botanicfields/BF-005/bf-005.jpg

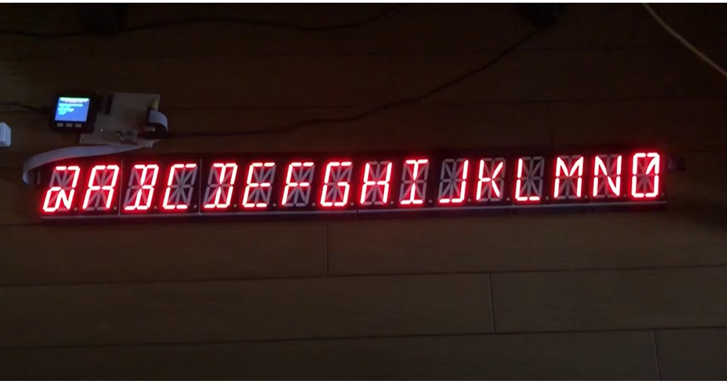
bf-005.jpg
