botanicfields/BF-005/20190802_M5Stack_TLC5940.pdf

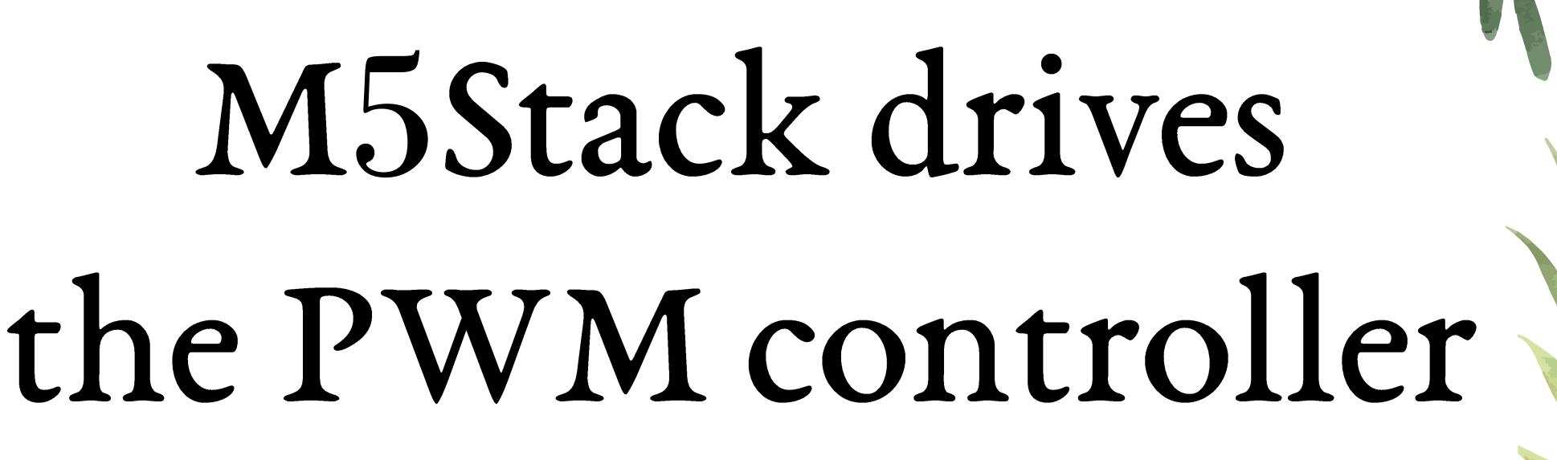
[picture p2: figure]

# TLC5940

16

2019/8/2

2019

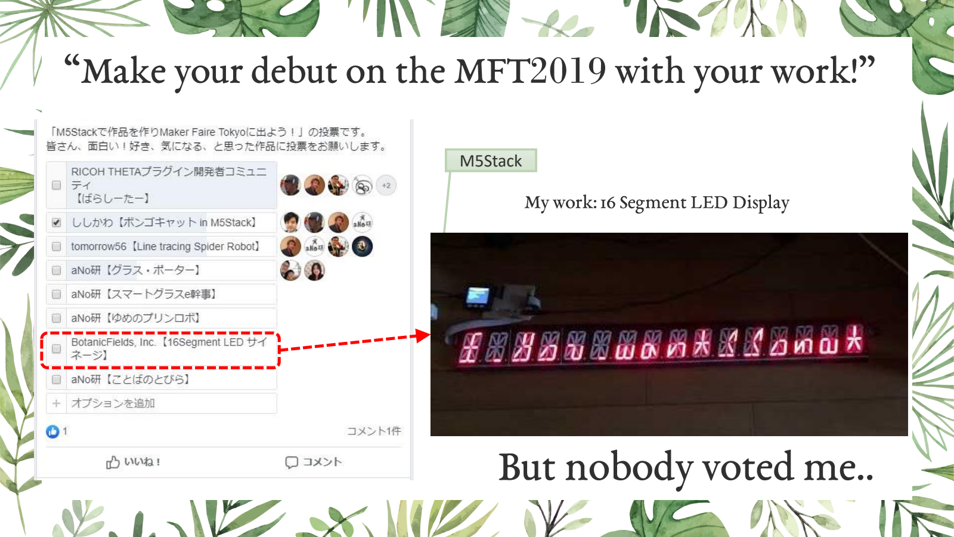
[picture p3: page 2]

M5Stack

# TLC5940

?

# TLC5940

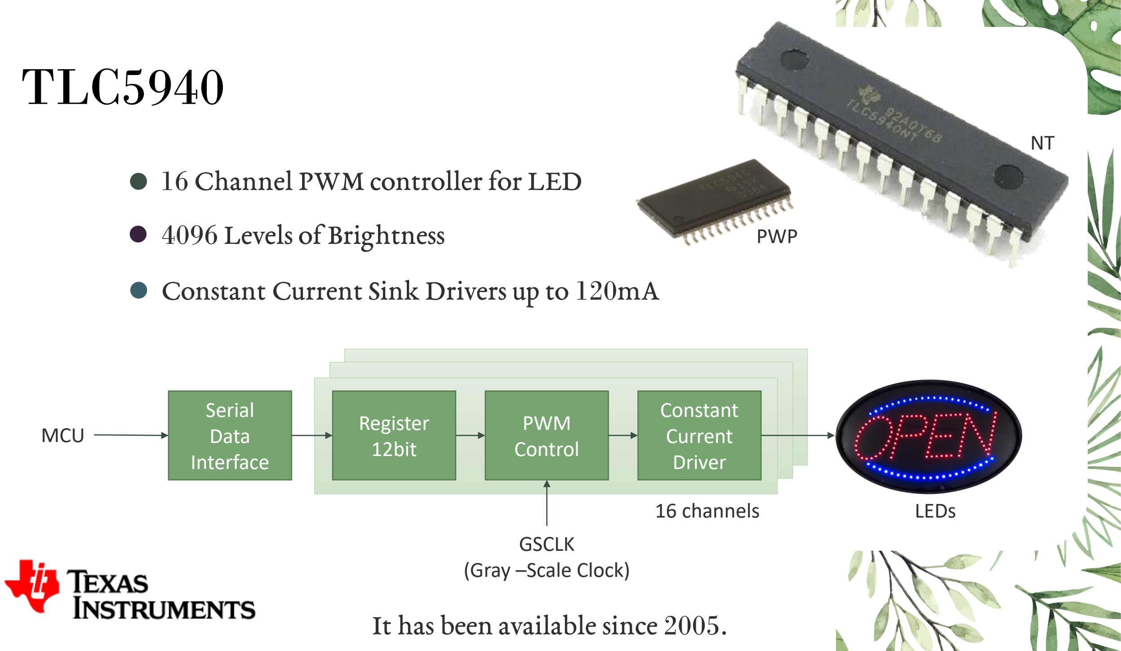
[picture p4: page 4]

120

16

4096

2005.

Constant
Current
Driver

PWM
Control

Register
12bit

Serial
Data
Interface
16 channels | LEDs

MCU

PWP

NT

GSCLK
(Gray –Scale Clock)

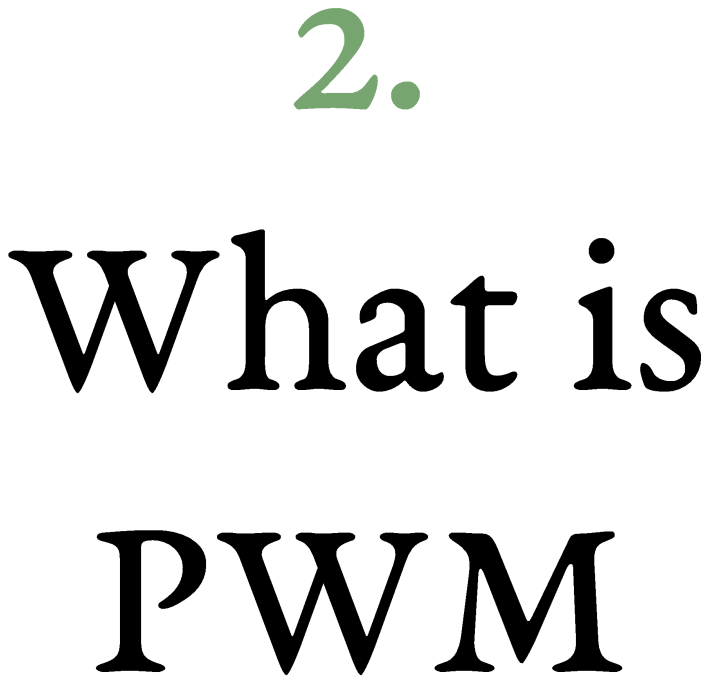
[picture p5: figure]

?

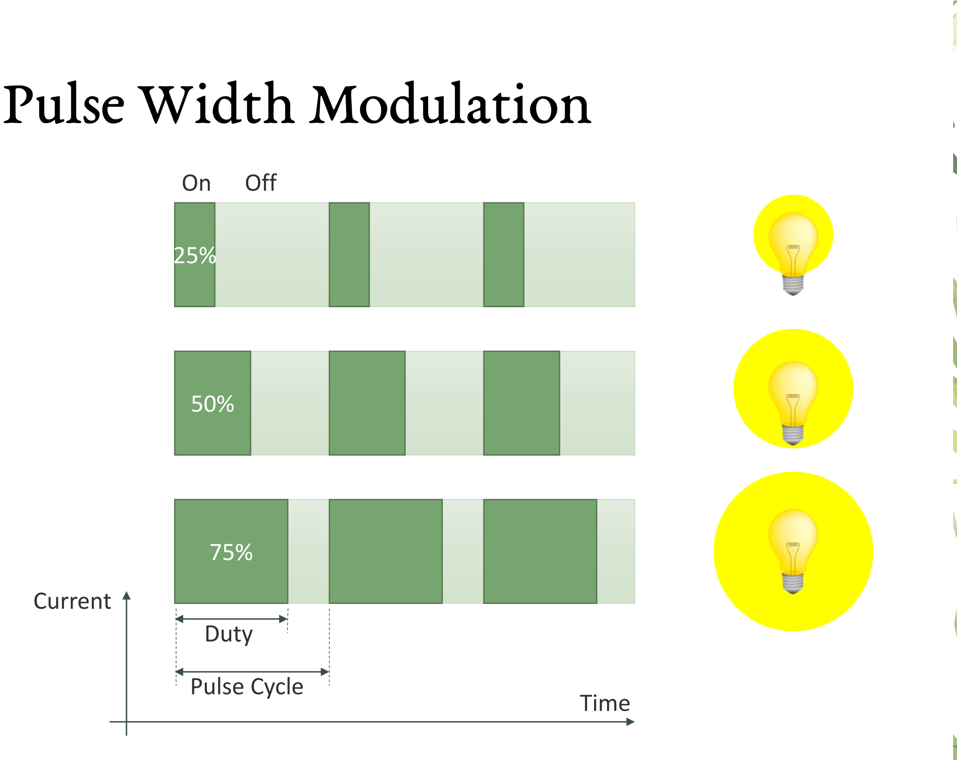
[picture p6: figure]
Pulse Cycle; Duty; Off; Time; Current

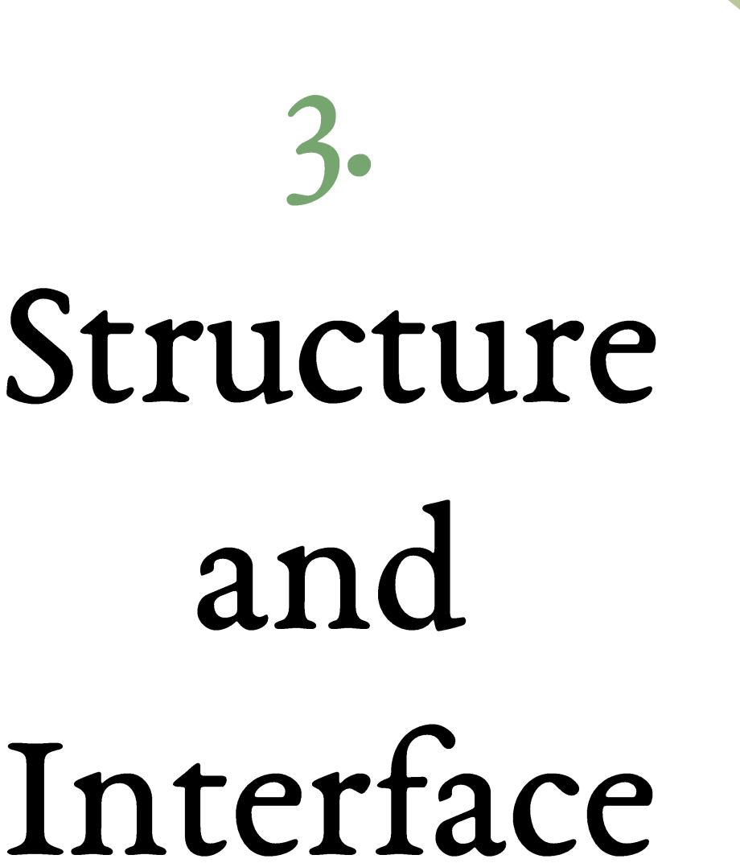
[picture p7: figure]
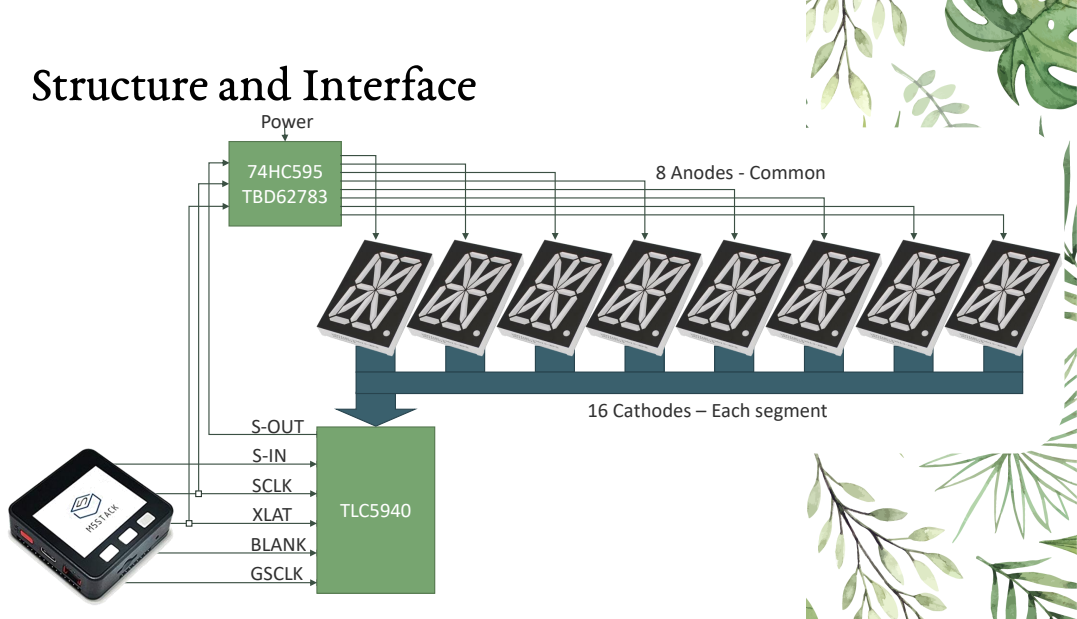
[picture p8: page 8]
TLC5940; 74HC595 TBD62783; Power; 8 Anodes - Common; GSCLK; BLANK; XLAT; SCLK; S-OUT

16 Cathodes – Each segment

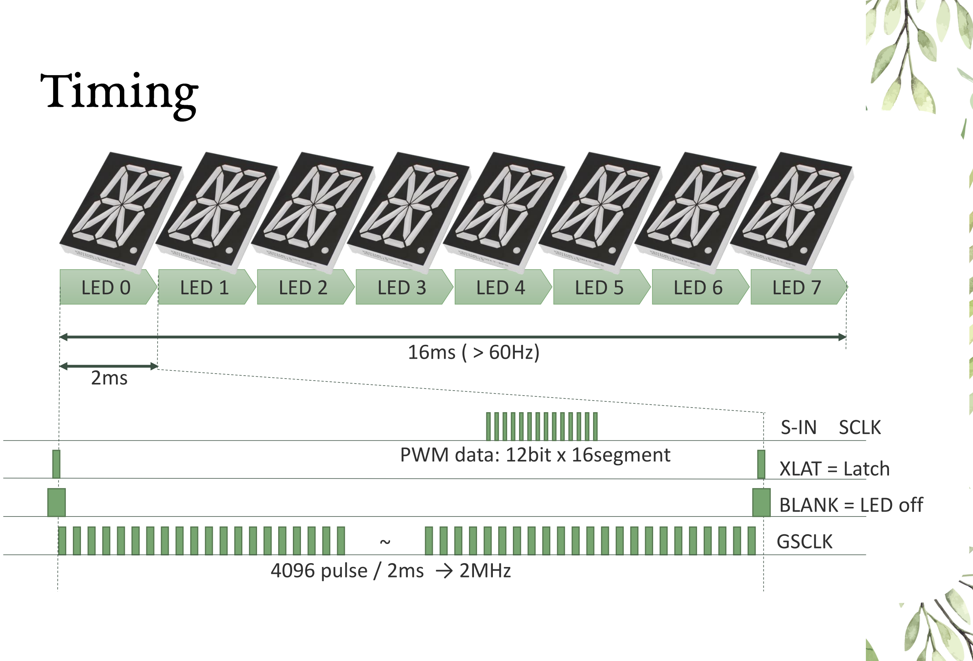
[picture p9: figure]
LED 0; LED 1; LED 2; LED 3; LED 4; LED 5; LED 6; LED 7; GSCLK; BLANK = LED off; XLAT = Latch; S-IN SCLK; 4096 pulse / 2ms → 2MHz; PWM data: 12bit x 16segment

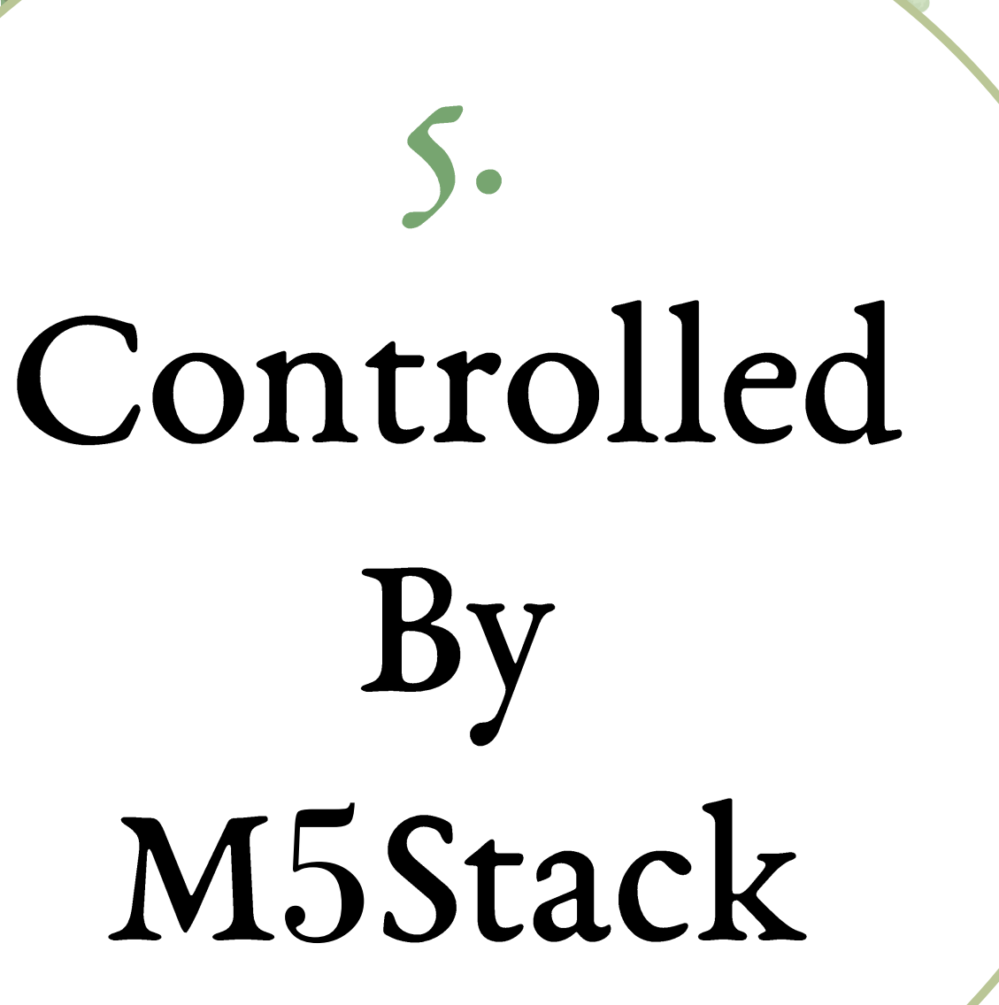
[picture p10: figure]

5 | 32

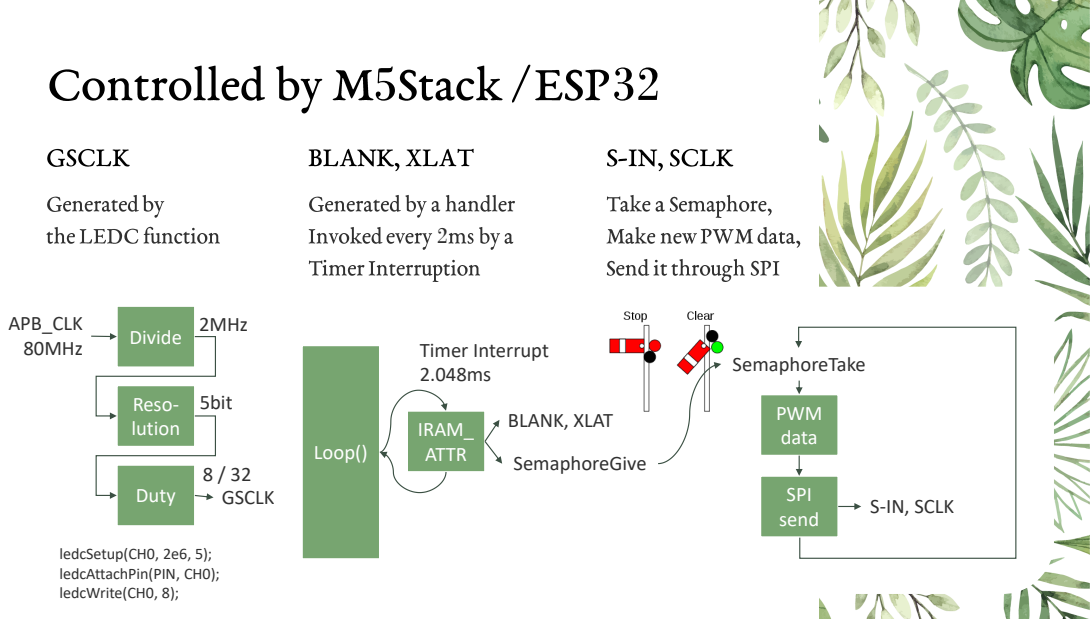
[picture p11: page 12]
Divide; Reso- lution; Duty; GSCLK; APB_CLK 80MHz; 5bit; 2MHz; ledcSetup(CH0, 2e6, 5); ledcAttachPin(PIN, CH0); ledcWrite(CH0, 8);; Loop(); IRAM_ ATTR; BLANK, XLAT; Timer Interrupt 2.048ms; SemaphoreGive; PWM data; SPI send; SemaphoreTake; S-IN, SCLK

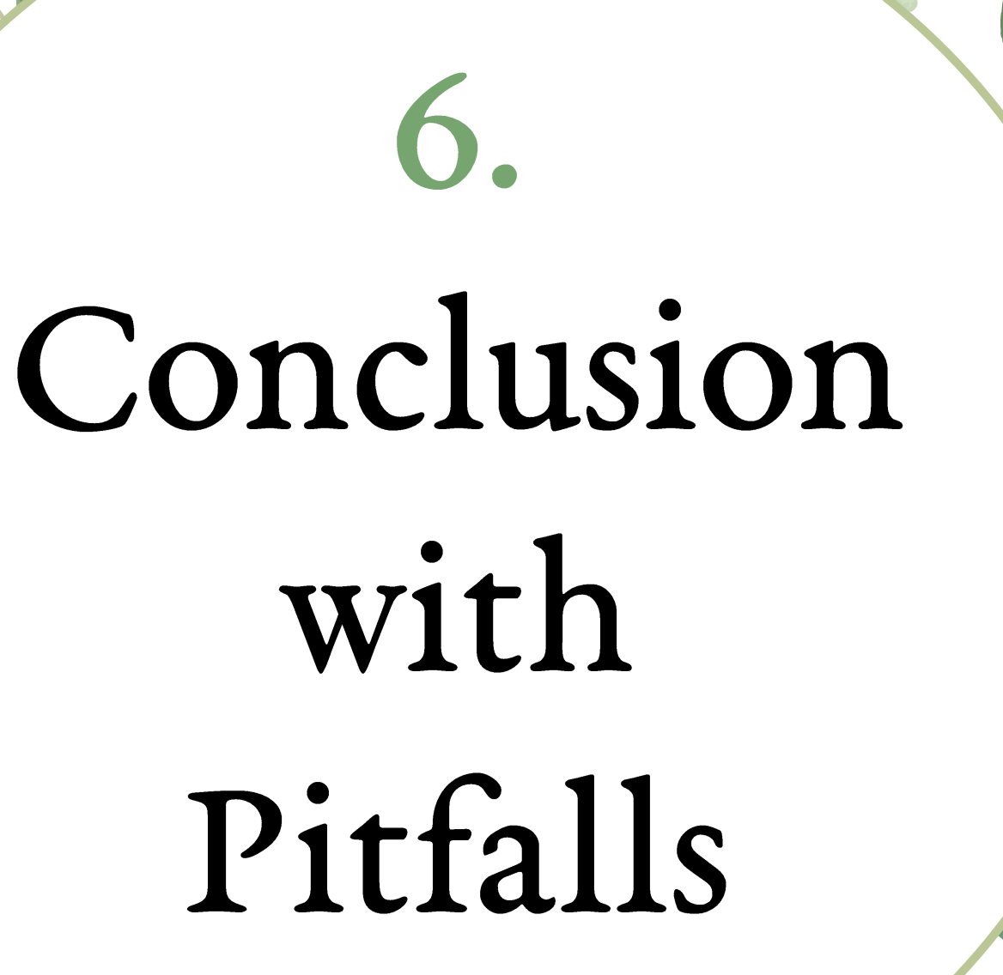
[picture p12: figure]

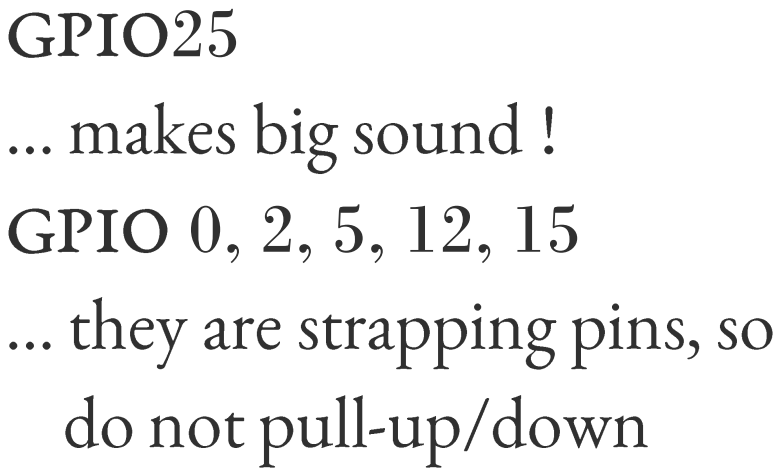
[picture p13: figure]
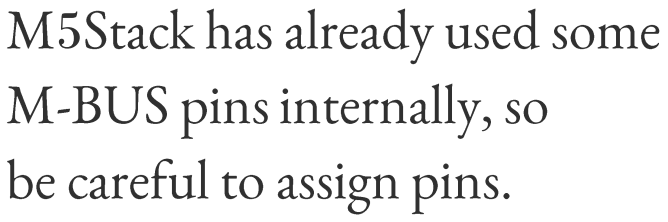
[picture p14: figure]

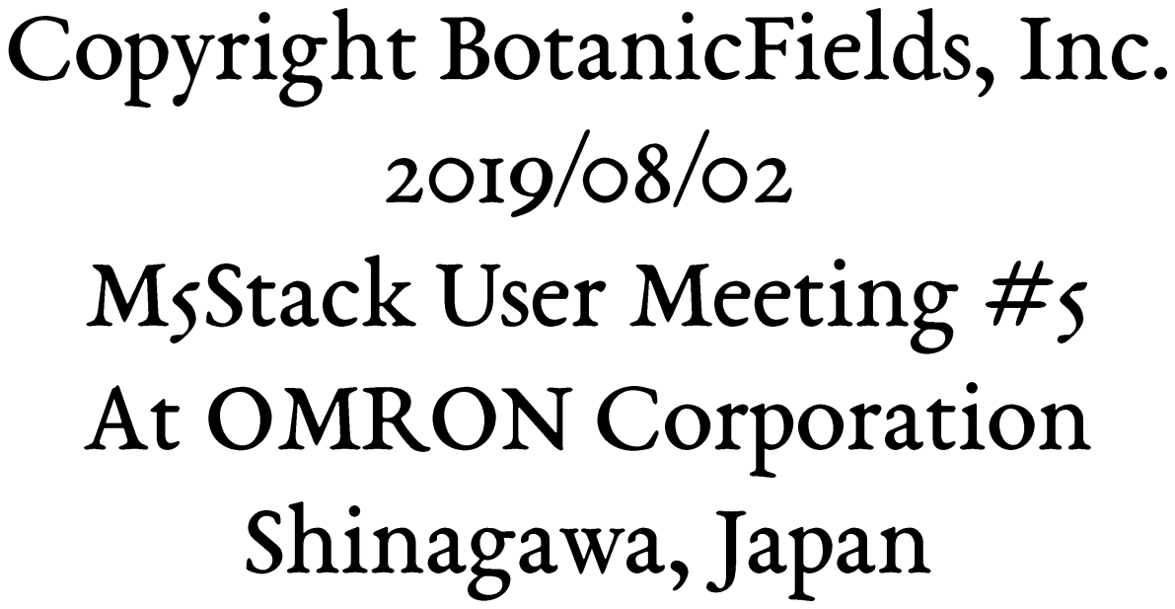
[picture p15: figure]
