botanicfields/BF-005/seg16font.pdf

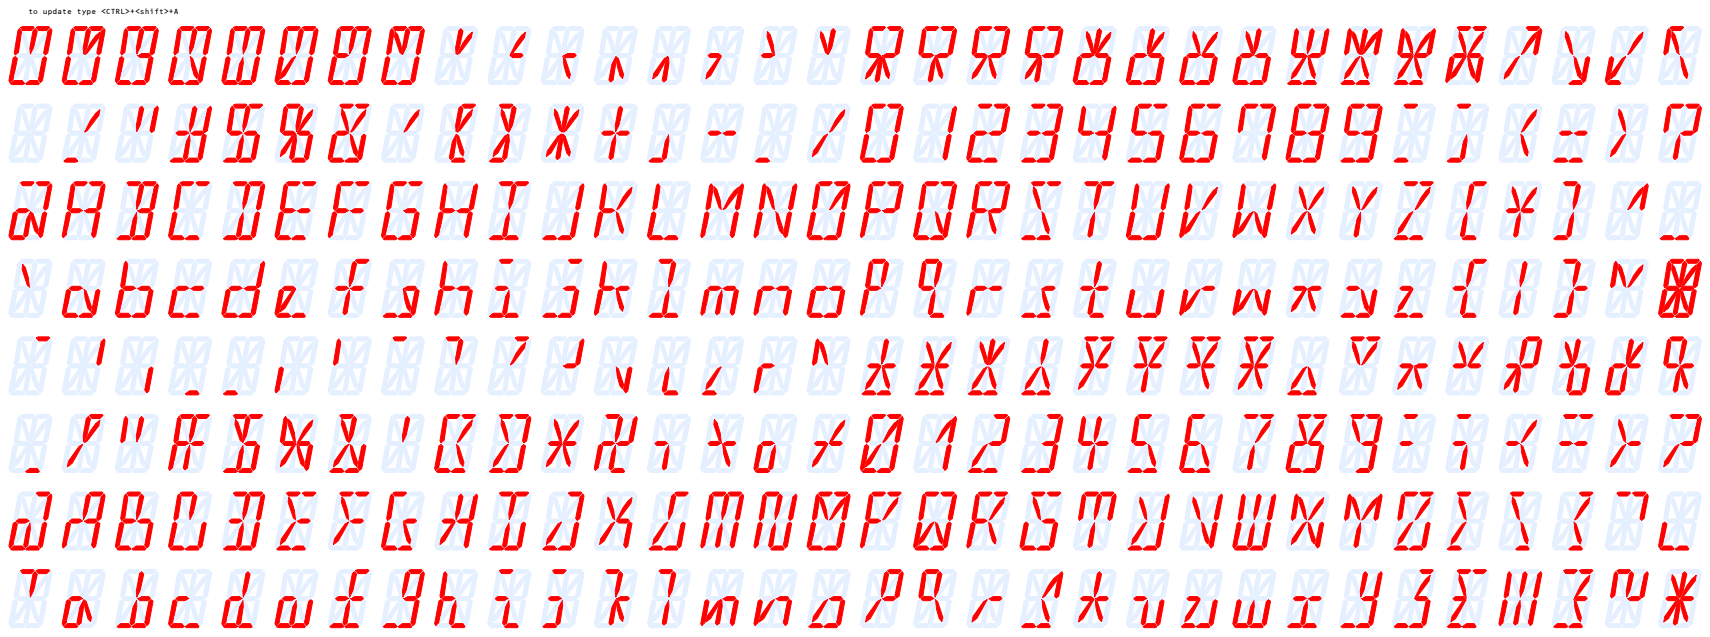
[picture p16: page 1]

to update type <CTRL>+<shift>+A
