botanicfields/BF-005/LEDC.png

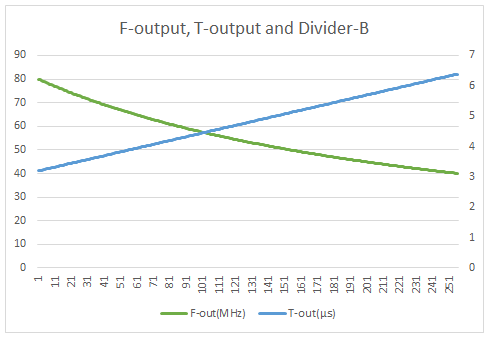
LEDC.png
