botanicfields/BF-005/BF-005V02L02Scheme.pdf

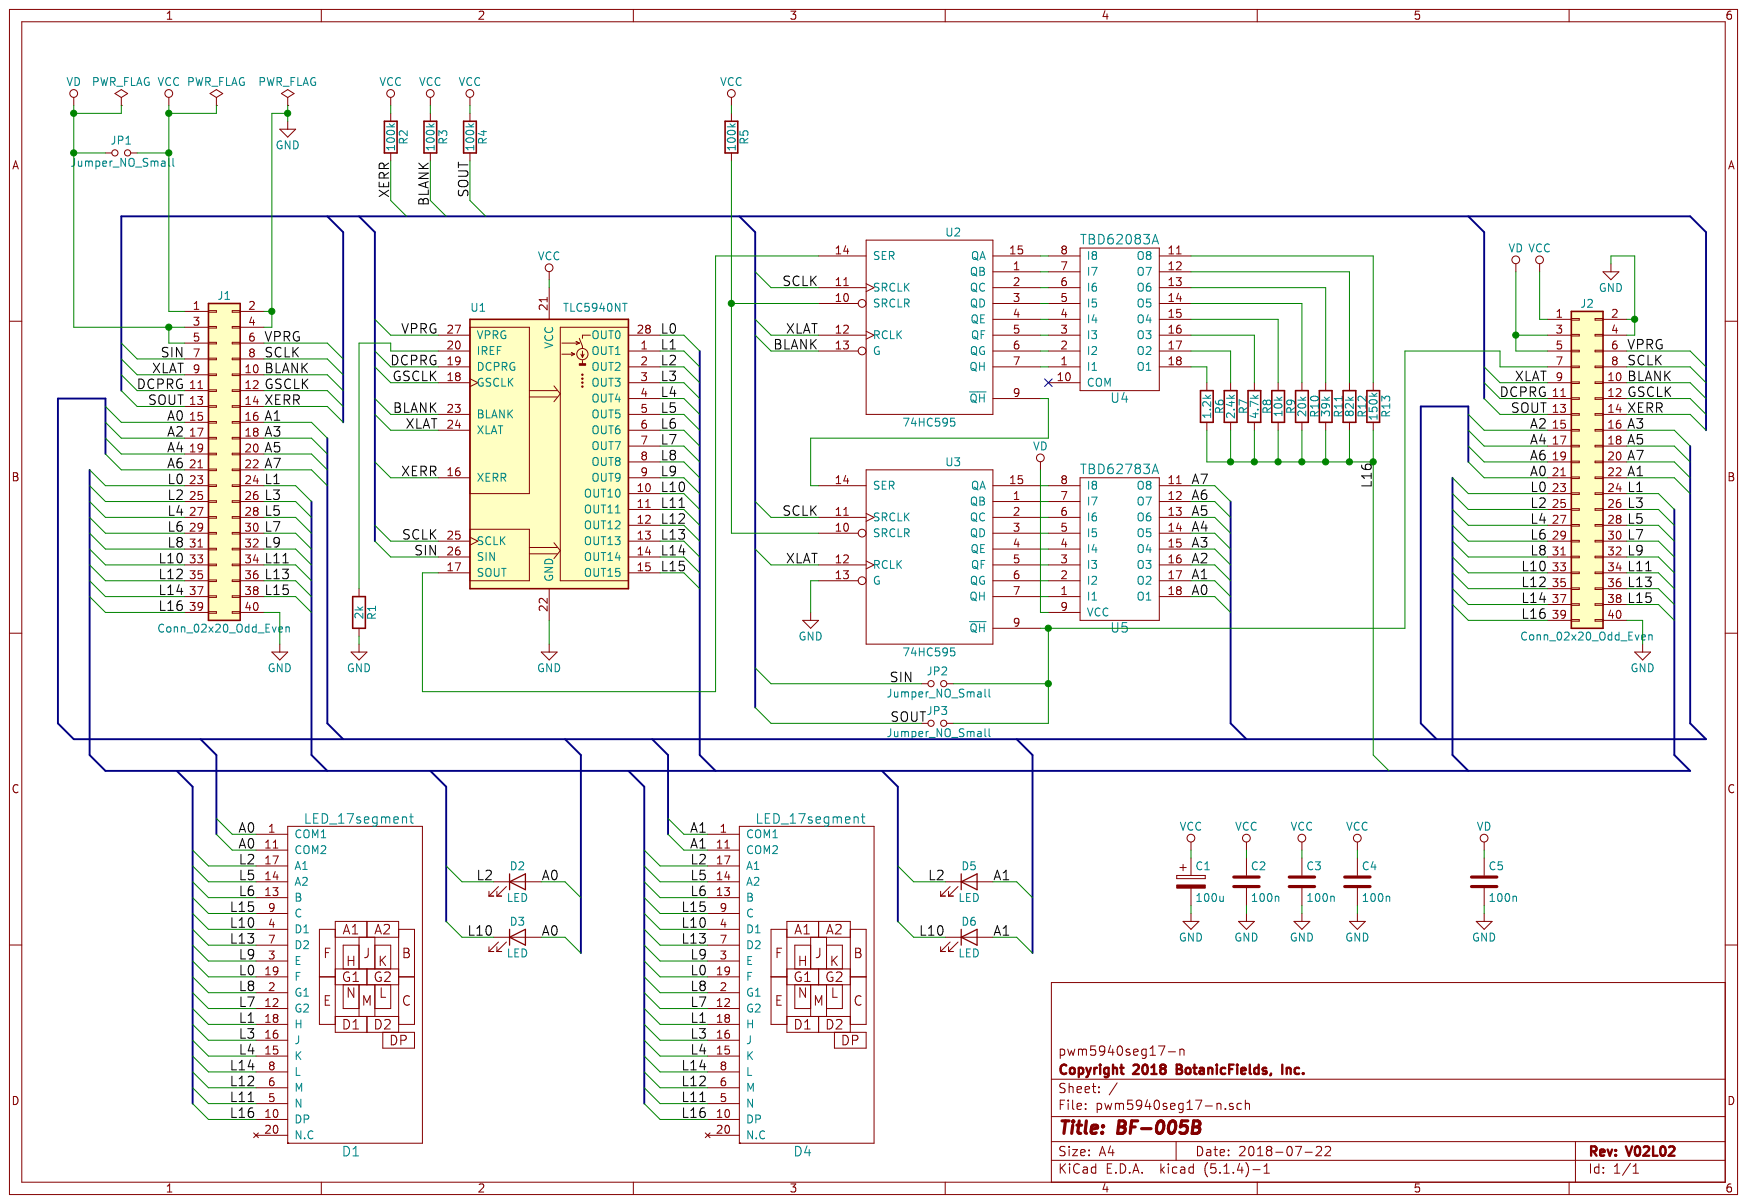
[picture p18: page 1]
