botanicfields/BF-005/BF-005V02L03LayoutB.pdf

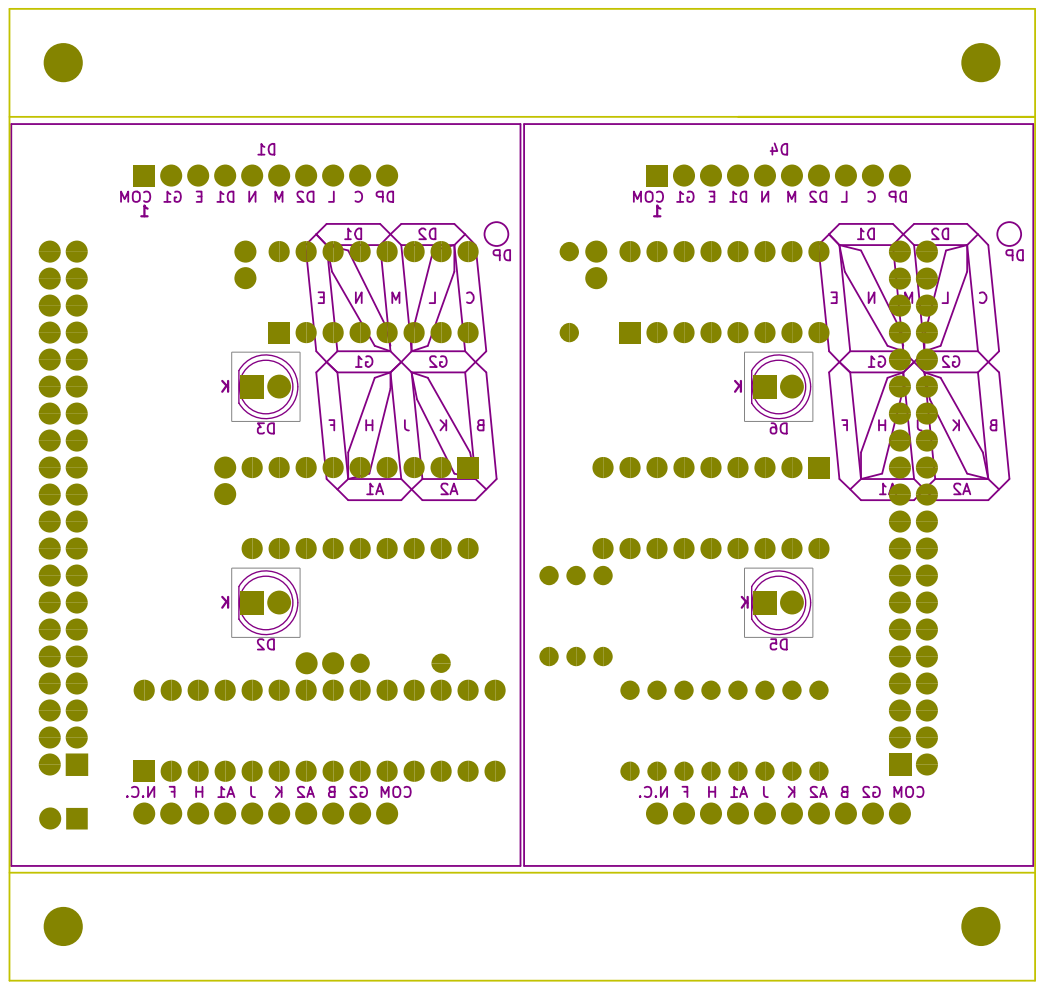
[picture p19: page 1]
