botanicfields/BF-005/BF-005V02L03LayoutF.pdf

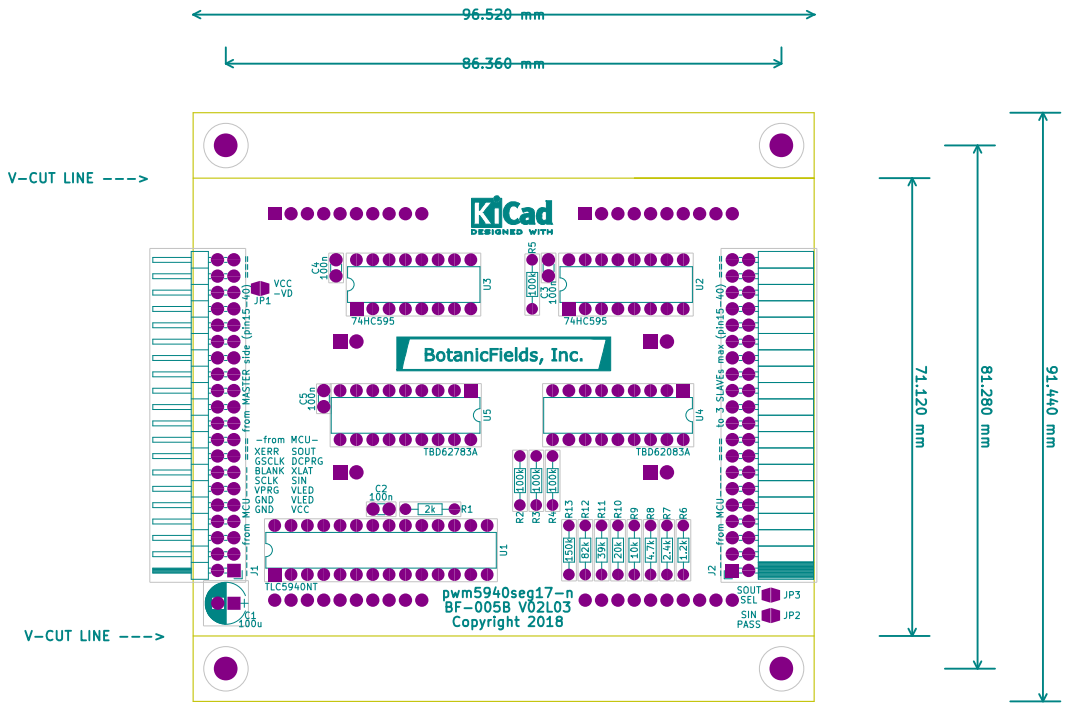
[picture p20: page 1]
